papparazzi/bilge-alarm/docs/verification/drc_report.txt

** Drc report for bilge_n2k_revC_routed.kicad_pcb **
** Created on 2026-10-31T21:04:29 **
** Report includes: Errors, Warnings, Exclusions **

** Found 0 DRC violations **

** Found 0 unconnected pads **

** Found 0 Footprint errors **

** Ignored checks **
    - Footprint has no courtyard defined
    - Track endpoint not centered on via
    - Tuning profile track geometries
    - Footprint doesn't match symbol's footprint filters
    - Footprint component type doesn't match footprint pads

** End of Report **
