papparazzi/bilge-alarm/datasheets/SOURCES.md

# Datasheet sources
- MS5637-02BA03 (TE Connectivity / MEAS), DS 06/2017: te.com document delivery (pin table p.14, package drawing p.14, pad layout p.15).
- AP63205 (Diodes Inc.) DS41326 Rev 3-2: diodes.com/assets/Datasheets/AP63200-AP63201-AP63203-AP63205.pdf
- L78L (STMicroelectronics) DS0424 Rev 30: st.com/resource/en/datasheet/l78l.pdf (pin connection Fig. 2, page 3)
- CA-IS3050G (Chipanalog) Version 1.10: text extract only (original PDF not stored).
- ESP32-S3-DevKitC-1 v1.1 (Espressif): dimension drawing and DXF from dl.espressif.com; user guide https://docs.espressif.com/projects/esp-dev-kits/en/latest/esp32s3/esp32-s3-devkitc-1/user_guide_v1.1.html
- DG127S-5.08 (Degson) drawing 10001534: it.degson.com product page details_552_3552465; used as the equivalent of DORABO DB127S-5.08 (same ratings and height). NOT available to the author (please check): the DORABO DB127S-5.08 drawing itself (LCSC C2997519 / C2997521), the AliExpress DZQJ clone's own schematic and dimensions, Bourns SRN6045TA-4R7M (parametric data taken from JLCPCB's listing), SMBJ15CA hongjiacheng datasheet, Littelfuse 1812L150/24MR datasheet.
