papparazzi/bilge-alarm/case/ref/esp32_top_flat.png

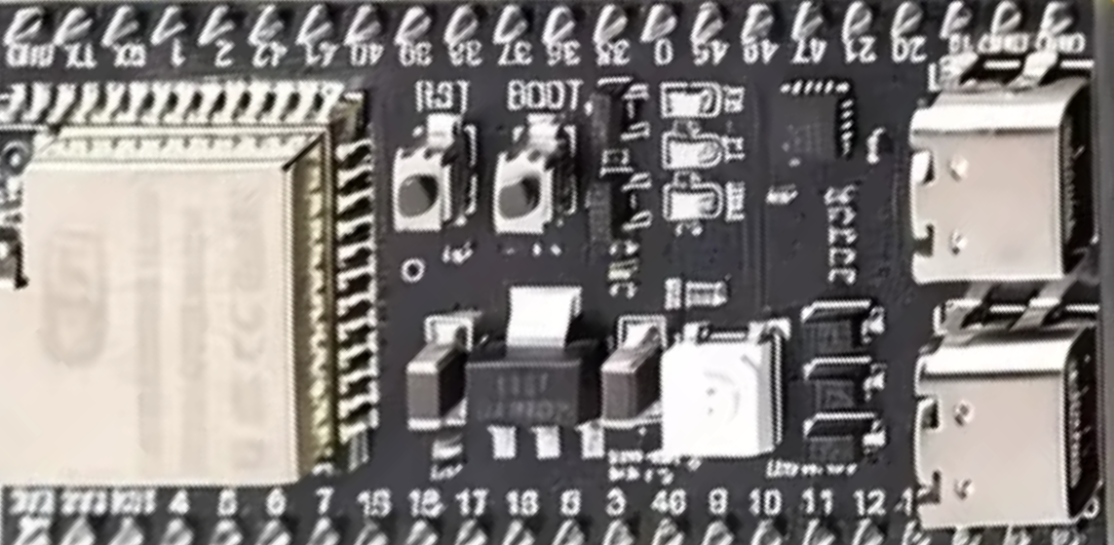
case/ref/esp32_top_flat.png
