papparazzi/bilge-alarm/case/renders/cradle_top.png

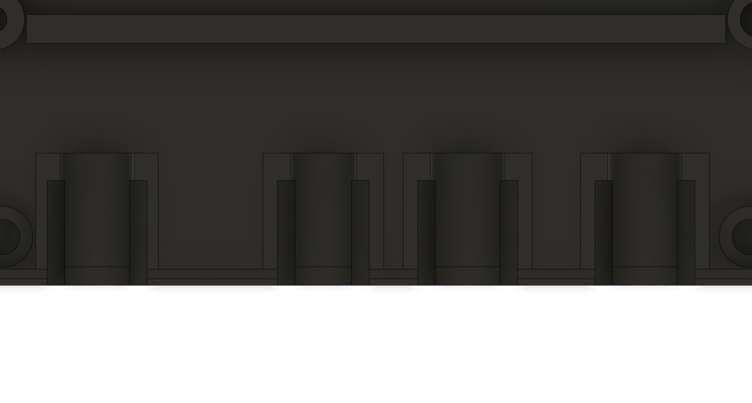
case/renders/cradle_top.png
