papparazzi/bilge-alarm/datasheets/clone_dimensions_from_seller.png

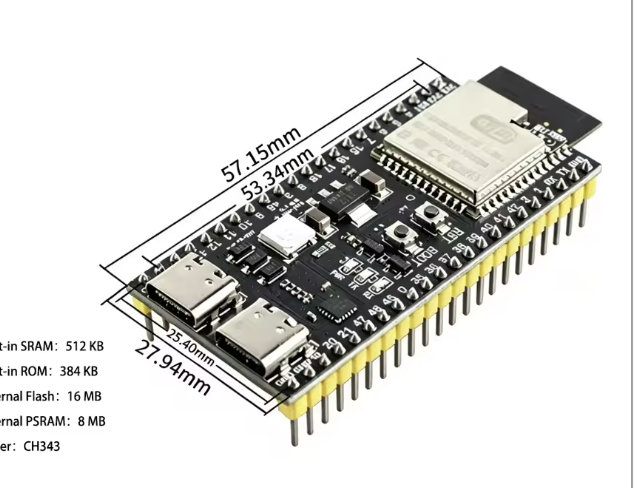
datasheets/clone_dimensions_from_seller.png
