papparazzi/bilge-alarm/datasheets/clone_silkscreen_photo_from_listing.png

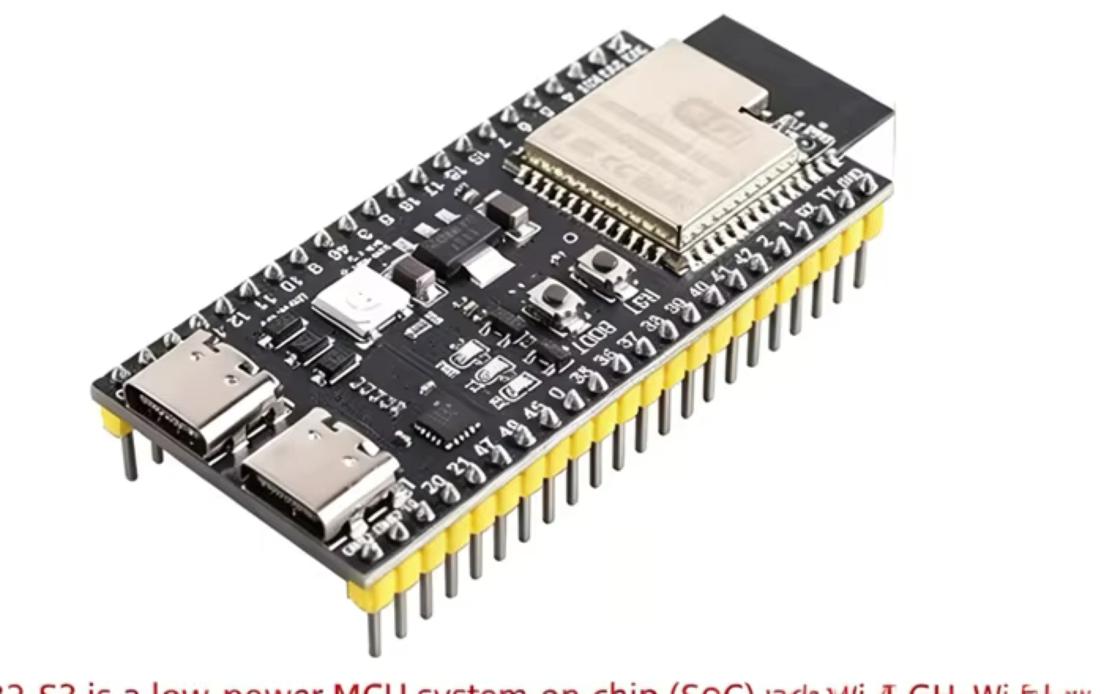
datasheets/clone_silkscreen_photo_from_listing.png
