papparazzi/bilge-alarm/docs/images/connectors_bottom_edge.png

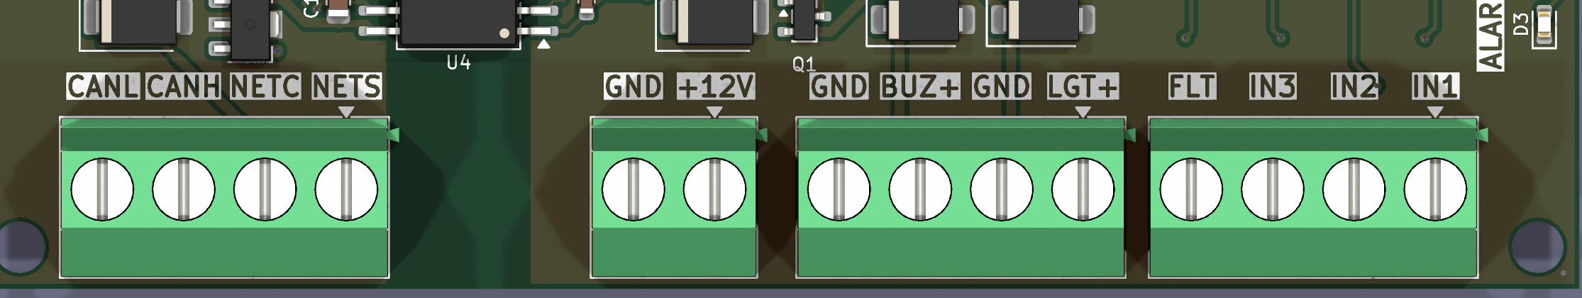
docs/images/connectors_bottom_edge.png
