papparazzi/bilge-alarm/case/print/mute_plunger.step

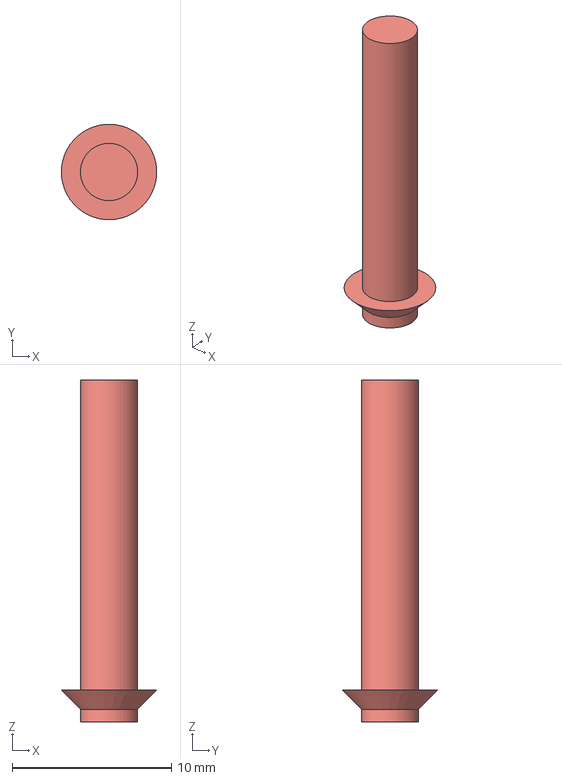
[picture p18: CAD file, 2026-11-11]
case/print/mute_plunger.step
5.99 x 6.00 x 21.5 mm
