papparazzi/bilge-alarm/case/print/case_base.step

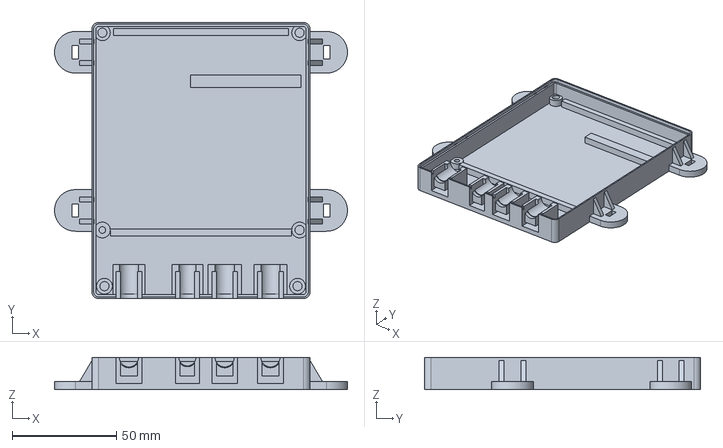
[picture p21: CAD file, 2026-11-11]
case/print/case_base.step
140.8 x 132.8 x 15.5 mm
