papparazzi/bilge-alarm/case/ref/bilge_pcb_kicad_silk.step

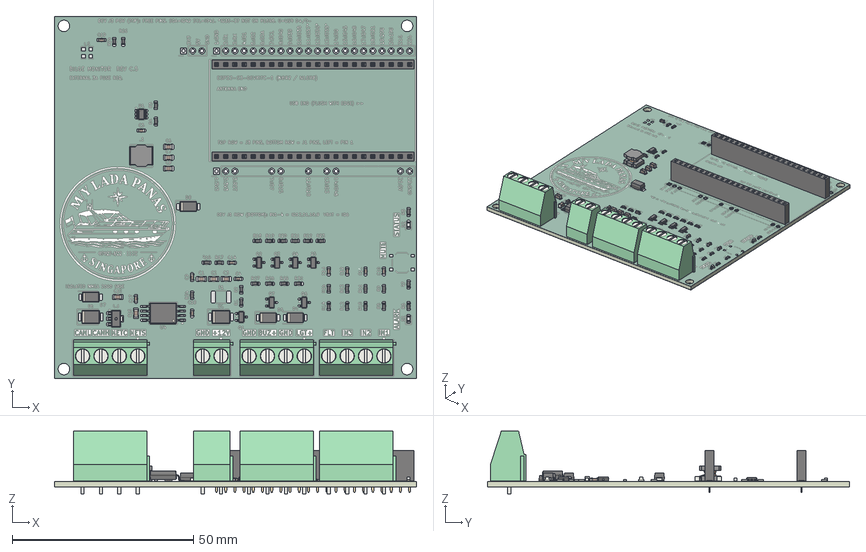
[picture p22: CAD file, 2026-11-11]
case/ref/bilge_pcb_kicad_silk.step
100.0 x 100.0 x 17.3 mm
R_0603_1608Metric x 30
C_0603_1608Metric x 11
C_0805_2012Metric x 8
D_SMB x 2
SOT-23 x 7
adbeea57-9c39-11ed-93f0-dde97e994e83_part
adbeea58-9c39-11ed-93f0-dde97e994e83_part
adbeea59-9c39-11ed-93f0-dde97e994e83_part
SOIC-8_7.5x5.85mm_P1.27mm
TerminalBlock_Phoenix_MKDS-1,5-4-5.08_1x04_P5.08mm_Horizontal x 3
D_SMA x 4
TSOT-23-6
LED_0603_1608Metric x 2
PinSocket_1x22_P2.54mm_Vertical x 2
L_Bourns_SRN6045TA
TerminalBlock_Phoenix_MKDS-1,5-2-5.08_1x02_P5.08mm_Horizontal
bilge_n2k_revC_routed_pad
bilge_n2k_revC_routed_silkscreen
bilge_n2k_revC_routed_soldermask x 2
bilge_n2k_revC_routed_PCB
