papparazzi/bilge-alarm/case/print/case_cover.step

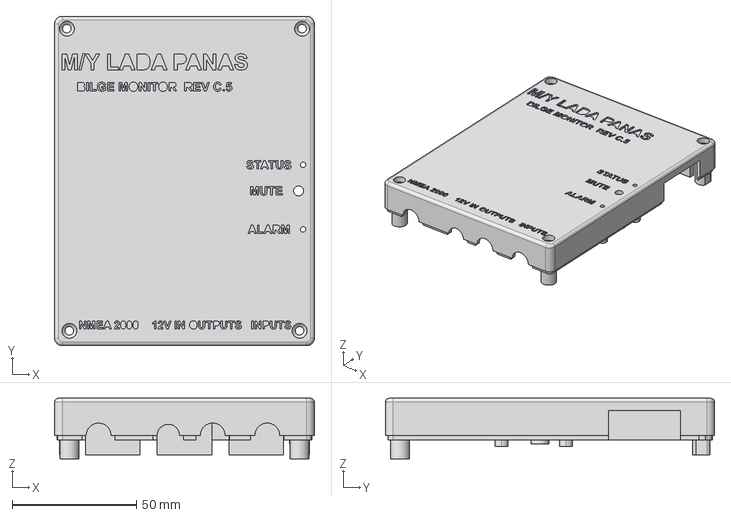
[picture p23: CAD file, 2026-11-11]
case/print/case_cover.step
104.8 x 132.8 x 24.4 mm
