papparazzi/bilge-alarm/(list of files, cad)

Other CAD files:
case/fusion/bilge_alarm_case_revC5.f3d
case/print/case_base.stl
case/print/case_cover.stl
case/print/mute_plunger.stl
