papparazzi/bilge-alarm/mfg/bilge_n2k_revC_assembly_top.pdf

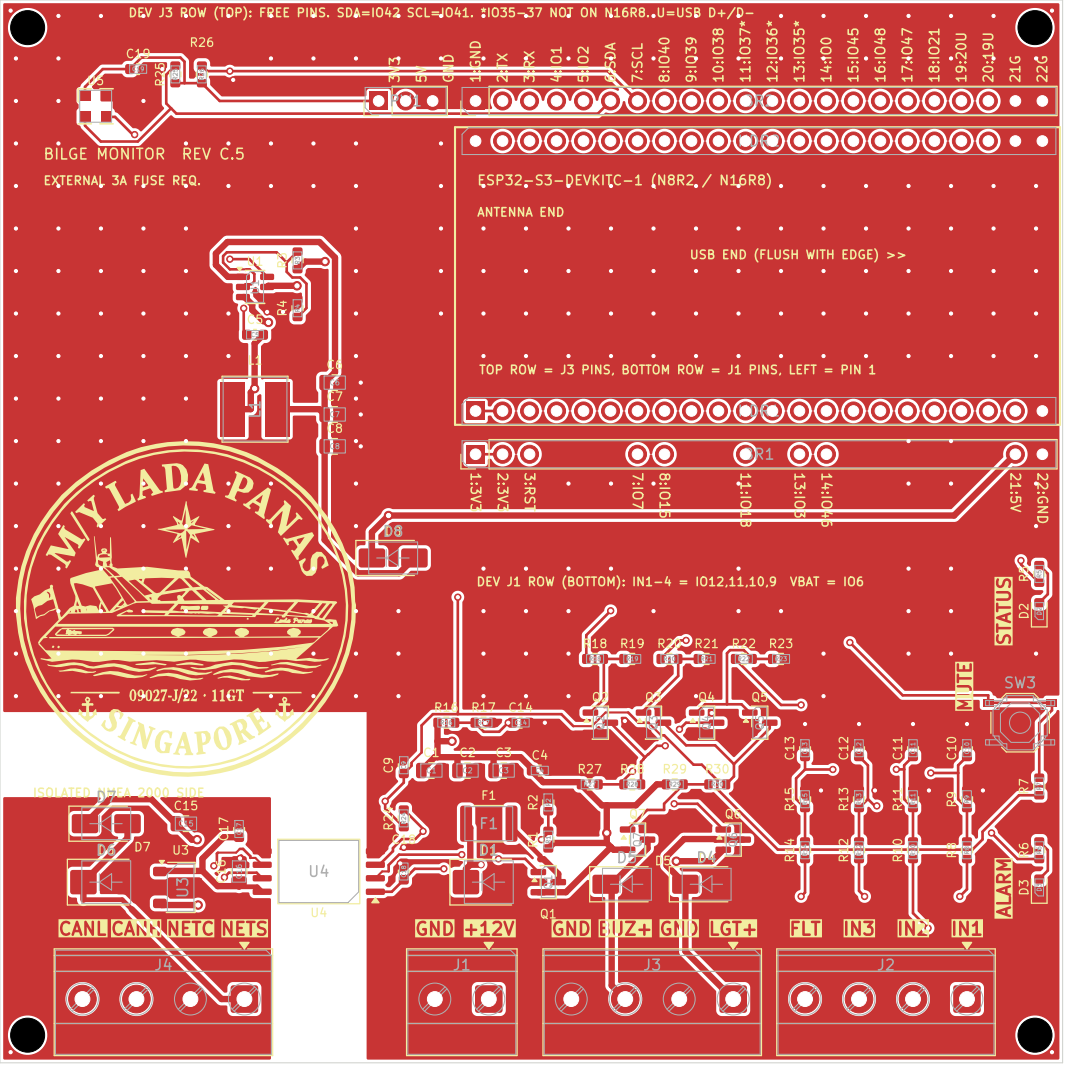
[picture p24: page 1]

EXTERNAL 3A FUSE REQ. DEV J3 ROW (TOP): FREE PINS. SDA=IO42 SCL=IO41. *IO35-37 NOT ON N16R8. U=USB D+/D-

TOP ROW = J3 PINS, BOTTOM ROW = J1 PINS, LEFT = PIN 1 USB END (FLUSH WITH EDGE) >>

DEV J1 ROW (BOTTOM): IN1-4 = IO12,11,10,9 VBAT = IO6
