papparazzi/bilge-alarm/mfg/bilge_n2k_revC_copper_bottom.pdf

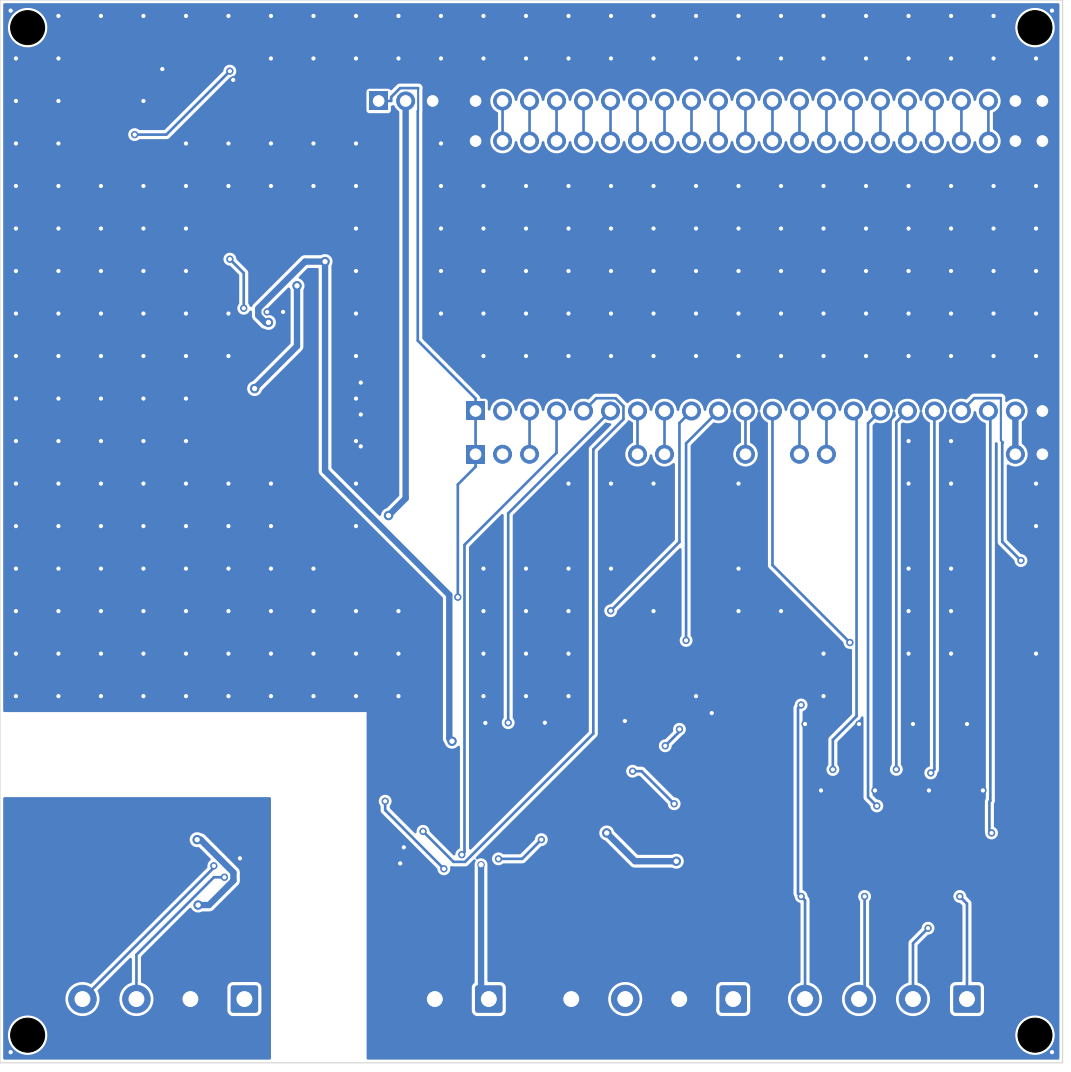
[picture p25: page 1]
