papparazzi/bilge-alarm/kicad/bilge_n2k_revC_routed.kicad_pcb

## KiCad design kicad/bilge_n2k_revC_routed.kicad_pcb (2026-11-11)

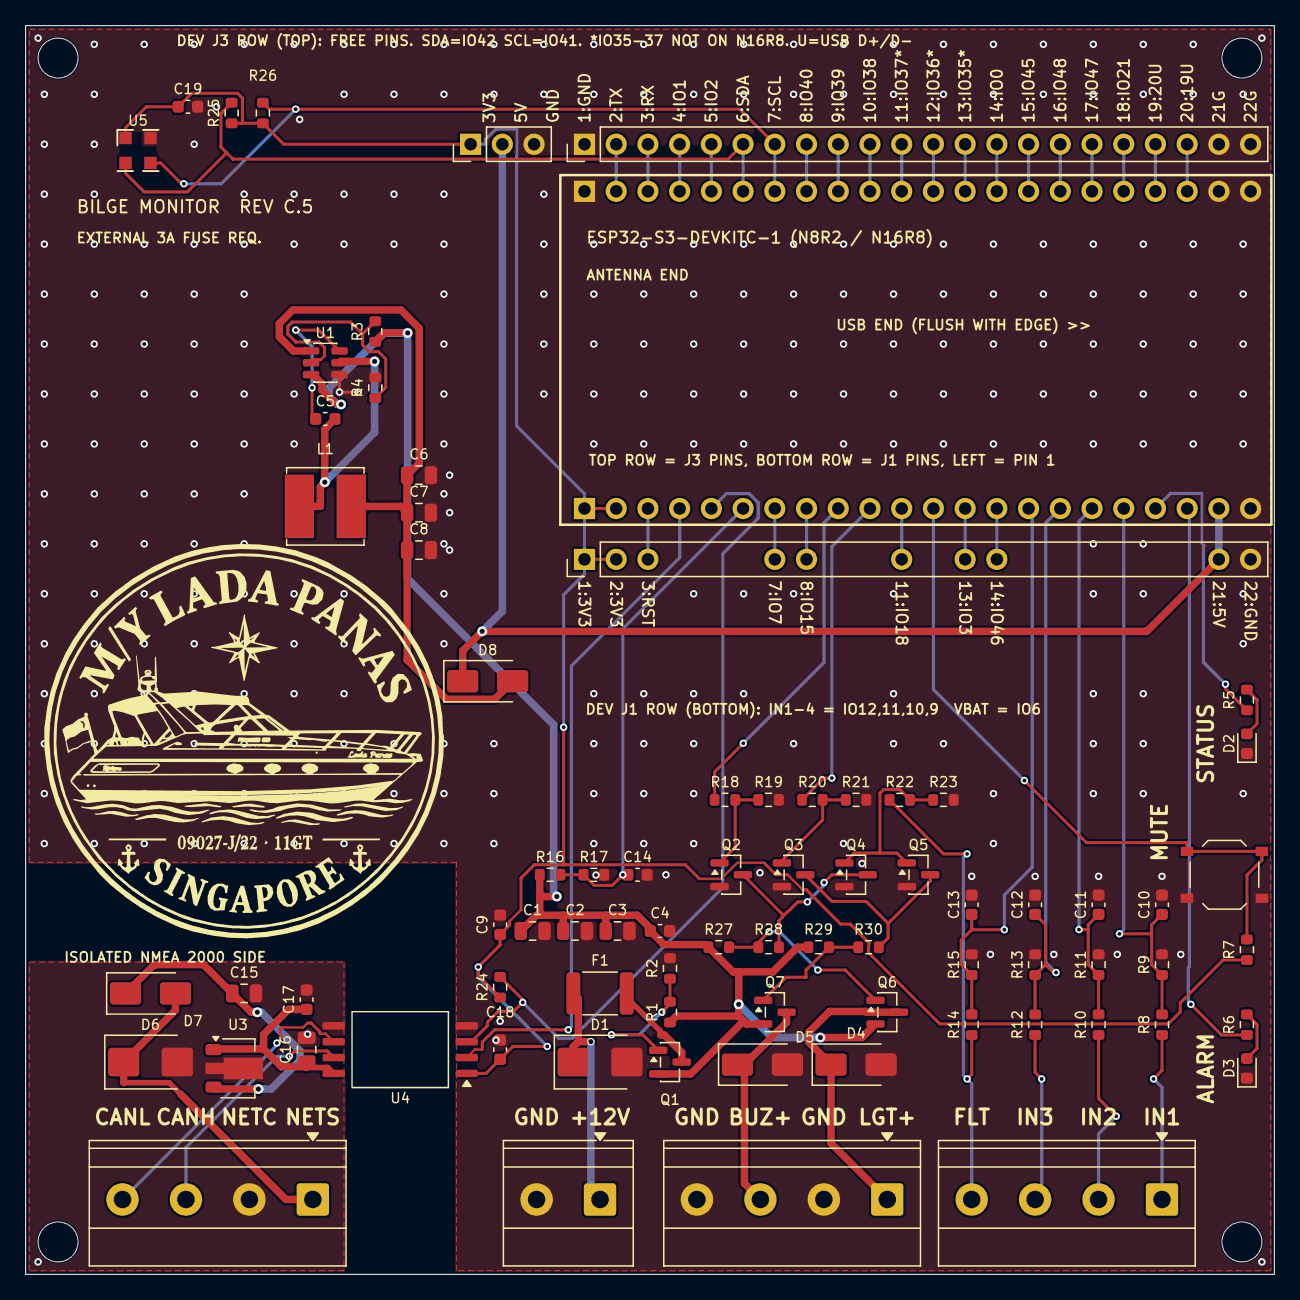
[picture p26: board bilge_n2k_revC_routed.kicad_pcb from above]

Board: 2 copper layers, 100.0 x 100.0 mm, 84 parts (0 on the bottom side), 69 nets.

Parts:
BR1, BR2: M3; PinHeader_1x22_P2.54mm_Vertical
C1, C2, C3, C15, C16: CL21A106KAYNNNE; C_0805_2012Metric
C4, C5, C9, C10, C11, C12, C13, C14, C17, C18, C19: CC0603KRX7R9BB104; C_0603_1608Metric
C6, C7, C8: CL21A226MAQNNNE; C_0805_2012Metric
D1, D6: SMBJ15CA; D_SMB
D2, D3: KT-0603R; LED_0603_1608Metric
D4, D5, D7, D8: SS14; D_SMA
F1: SMD1812-200-24; Fuse_1812_4532Metric
H1, H2, H3, H4: M3; MountingHole_3.2mm_M3
HDR1, HDR2: HC-PM254-8.5H-1x22PZ; PinSocket_1x22_P2.54mm_Vertical
J1: DB127S-5.08-2P-GN-S; TerminalBlock_Phoenix_MKDS-1,5-2-5.08_1x02_P5.08mm_Horizont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
J2, J3, J4: DB127S-5.08-4P-GN-S; TerminalBlock_Phoenix_MKDS-1,5-4-5.08_1x04_P5.08mm_Horizont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
L1: SRN6045TA-4R7M; L_Bourns_SRN6045TA
PW1: M3; PinHeader_1x03_P2.54mm_Vertical
Q1, Q6, Q7: AO3401A; SOT-23
Q2, Q3, Q4, Q5: AO3400A; SOT-23
R1, R4, R23, R28, R30: 0603WAF4702T5E; R_0603_1608Metric
R2, R3, R8, R10, R12, R14, R16, R19, R21, R22: 0603WAF1003T5E; R_0603_1608Metric
R5, R6: 0603WAF4700T5E; R_0603_1608Metric
R7, R24: 0603WAF1002T5E; R_0603_1608Metric
R9, R11, R13, R15, R17: 0603WAF2702T5E; R_0603_1608Metric
R18, R20: 0603WAF1001T5E; R_0603_1608Metric
R25, R26: 0603WAF5101T5E; R_0603_1608Metric
R27, R29: 0603WAF2202T5E; R_0603_1608Metric
SW3: TS-1187A-B-A-B; SW_Push_1P1T_XKB_TS-1187A
U1: AP63205WU-7; TSOT-23-6
U3: L78L05ABUTR; SOT-89-3
U4: CA-IS3050G; SOIC-8_7.5x5.85mm_P1.27mm
U5: MS563702BA03-50; MS5637-02BA03_QFN-4_3x3mm

Connections:
+3V3: BR1.1, BR1.2, C9.1, C18.1, C19.1, HDR1.1, HDR1.2, PW1.1, R7.1, R24.1, R25.1, R26.1, U4.1, U5.1
+5V: C6.1, C7.1, C8.1, D8.2, L1.2, U1.1
+5V_ISO: C16.1, C17.1, U3.1, U4.8
BST: C5.1, U1.6
BTN_MUTE: HDR1.12, R7.2, SW3.1
BUZZ_CTL: HDR1.10, R20.1
BUZZ_OUT: D5.1, J3.3, Q7.3
B_G: Q3.1, R20.2, R21.1
B_PD: Q3.3, Q5.3, R30.2
B_PG: Q7.1, R29.2, R30.1
CANH_J: J4.3, U4.7
CANL_J: J4.4, U4.6
CAN_RX: HDR1.4, U4.2
CAN_TX: HDR1.5, R24.2, U4.3
DEV_5V: BR1.21, D8.1, HDR1.21, PW1.2
EN_BUCK: R3.2, R4.1, U1.2
GND: BR1.22, BR2.1, BR2.21, BR2.22, C1.2, C2.2, C3.2, C4.2, C6.2, C7.2, C8.2, C9.2, C10.2, C11.2, C12.2, C13.2, C14.2, C18.2, C19.2, D1.2, D2.1, D3.1, D4.2, D5.2, HDR1.22, HDR2.1, HDR2.21, HDR2.22, J1.2, J3.2, J3.4, PW1.3, Q2.2, Q3.2, Q4.2, Q5.2, R2.2, R4.2, R9.2, R11.2, R13.2, R15.2, R17.2, R19.2, R21.2, R23.2, SW3.2, U1.4, U4.4, U5.4
HW_G: Q4.1, Q5.1, R22.2, R23.1
I2C_SCL: BR2.7, HDR2.7, R26.2, U5.3
I2C_SDA: BR2.6, HDR2.6, R25.2, U5.2
IN1_A: C10.1, HDR1.18, R8.2, R9.1
IN1_RAW: J2.1, R8.1
IN2_A: C11.1, HDR1.17, R10.2, R11.1
IN2_RAW: J2.2, R10.1
IN3_A: C12.1, HDR1.16, R12.2, R13.1
IN3_RAW: J2.3, R12.1
IN4_A: C13.1, HDR1.15, R14.2, R15.1
IN4_RAW: J2.4, R14.1, R22.1
J1_P3: BR1.3, HDR1.3
J1_P7: BR1.7, HDR1.7
J1_P8: BR1.8, HDR1.8
J1_P11: BR1.11, HDR1.11
J1_P13: BR1.13, HDR1.13
J1_P14: BR1.14, HDR1.14
J3_P2: BR2.2, HDR2.2
J3_P3: BR2.3, HDR2.3
J3_P4: BR2.4, HDR2.4
J3_P5: BR2.5, HDR2.5
J3_P8: BR2.8, HDR2.8
J3_P9: BR2.9, HDR2.9
J3_P10: BR2.10, HDR2.10
J3_P11: BR2.11, HDR2.11
J3_P12: BR2.12, HDR2.12
J3_P13: BR2.13, HDR2.13
J3_P14: BR2.14, HDR2.14
J3_P15: BR2.15, HDR2.15
J3_P16: BR2.16, HDR2.16
J3_P17: BR2.17, HDR2.17
J3_P18: BR2.18, HDR2.18
J3_P19: BR2.19, HDR2.19
J3_P20: BR2.20, HDR2.20
LED_ALM: HDR1.20, R6.1
LED_ALM_A: D3.2, R6.2
LED_STAT: HDR1.19, R5.1
LED_STAT_A: D2.2, R5.2
LIGHT_CTL: HDR1.9, R18.1
LIGHT_OUT: D4.1, J3.1, Q6.3
L_G: Q2.1, R18.2, R19.1
L_PD: Q2.3, Q4.3, R28.2
L_PG: Q6.1, R27.2, R28.1
NET_C: C15.2, C16.2, C17.2, D6.2, J4.2, U3.2, U4.5
NET_S: D6.1, D7.2, J4.1
NET_SP: C15.1, D7.1, U3.3
Q1_G: Q1.1, R1.2, R2.1
SW: C5.2, L1.1, U1.5
VBAT_IN: D1.1, F1.1, J1.1
VFUSED: F1.2, Q1.3
VIN: C1.1, C2.1, C3.1, C4.1, Q1.2, Q6.2, Q7.2, R1.1, R3.1, R16.1, R27.1, R29.1, U1.3
VSENSE_A: C14.1, HDR1.6, R16.2, R17.1
