papparazzi/bilge-alarm/firmware/bench_test/secrets.example.h

// Copy this file to secrets.h in the same folder and set your own values.
// secrets.h stays on your computer: .gitignore keeps it out of the repository.
#pragma once

#define AP_PASSWORD "change-this-password"   // setup hotspot password (WPA2, 8-63 characters)
